opendata-nuernberg/molekula/keyboards/Molekula2/images/v1.0-front-3d.png

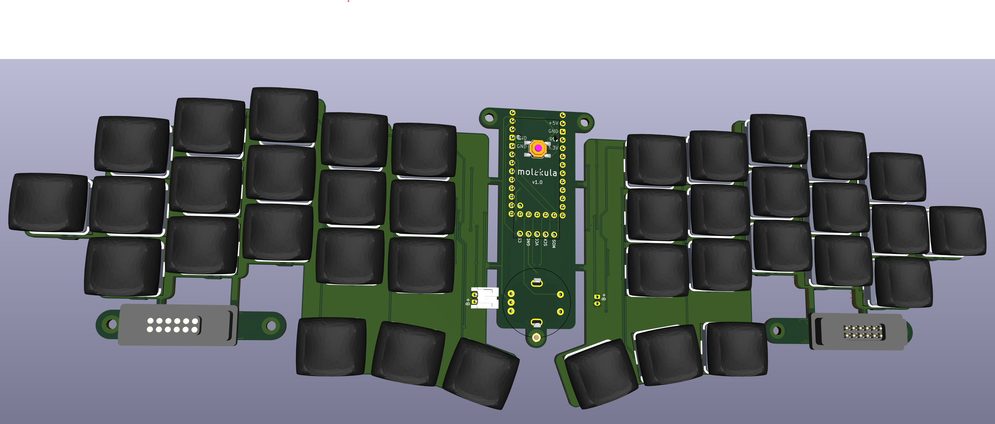
keyboards/Molekula2/images/v1.0-front-3d.png
