opendata-nuernberg/molekula/keyboards/Molekula2/images/v1.0-back-3d.png

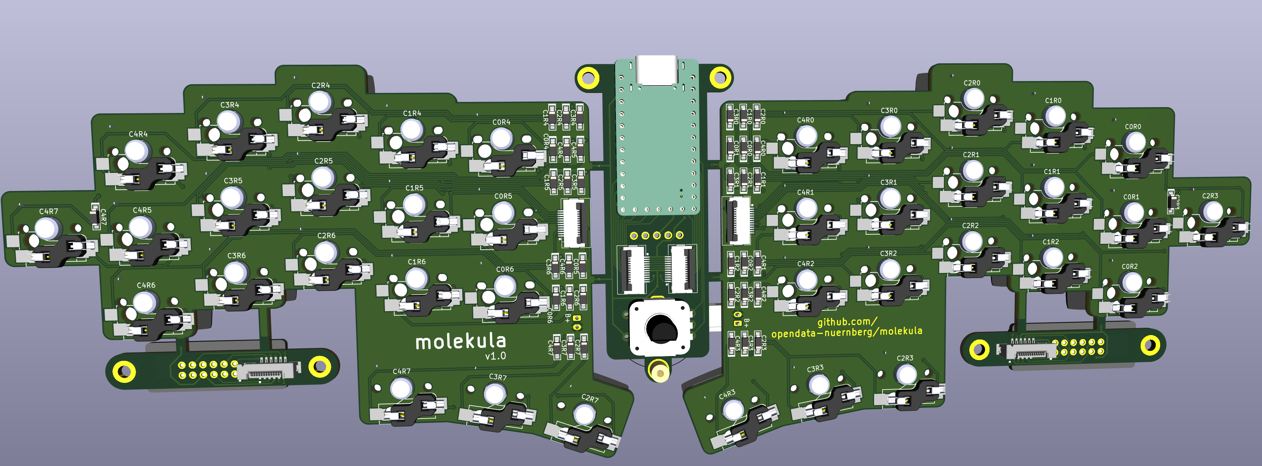
keyboards/Molekula2/images/v1.0-back-3d.png
