opendata-nuernberg/molekula/keyboards/Molekula2/production/202601-order.md

Order Sum: 201,17
[x] 6x MCU - [RP2040 Helios 16M](https://de.aliexpress.com/item/1005010018679591.html)
[x] 350x [Choc hotswap sockets](https://www.aliexpress.us/item/3256808357010978.html)
[x] 100x [MX hotswap sockets](https://www.aliexpress.us/item/3256807045726008.html)
[x] 200x [SMD SOD-123 1N4148w](https://www.aliexpress.us/item/3256809479695335.html) diodes
[x] 10x [Magnetic connector 12pin](https://www.aliexpress.us/item/3256804525488442.html)
[x] 10x rotary encoder, [low profile EC12](https://www.aliexpress.com/item/1005003636548797.html) is recommended (no click though). Versions with click often has issues with power consumption, be careful
[x] 6x [30mm knob](https://www.aliexpress.us/item/3256810097582487.html)
[x] 10x Vertical 12pin 0.5mm [FFC/FPC connector](https://www.aliexpress.com/item/10000000737049.html)
[x] 20x Horizontal 12pin 0.5mm [FFC/FPC connector](https://de.aliexpress.com/item/4001186849063.html)
[x] 20x 12pin 0.5mm 5cm [FFC cable](https://de.aliexpress.com/item/1005007102943270.html) - reverse direction
[x] 20x 12pin 0.5mm 5cm [FFC cable](https://www.aliexpress.com/item/1005007561337665.html) - same side (forward direction)
[x] 10x SMD 4x4x1.5mm [push button](https://de.aliexpress.com/item/1005004312015111.html)
[x] 10 x 2.54mm female pin [headers](https://www.aliexpress.com/item/4001122376295.html)
[x] 5pin [headers](https://de.aliexpress.com/item/1005009098260709.html) - source of pins for socketing, and also a connector for nice!view
