opendata-nuernberg/molekula/keycaps/choc sculpted/choc_caps_print_ready.step

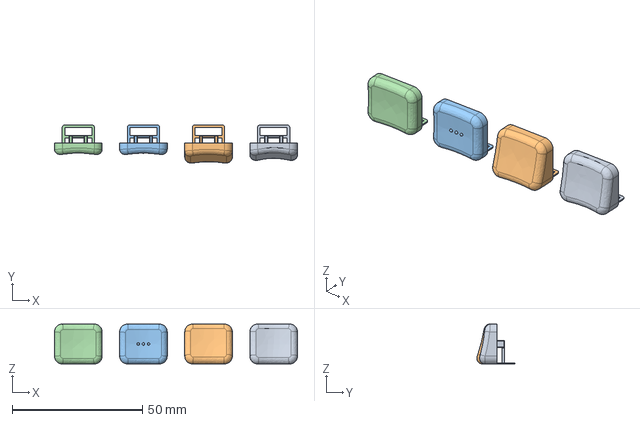
[picture p3: CAD file, 2026-01-31]
keycaps/choc sculpted/choc_caps_print_ready.step
93.3 x 14.7 x 15.3 mm
cap_default_rounded x 4
