opendata-nuernberg/molekula/print_files/keyboard_artisan.3mf

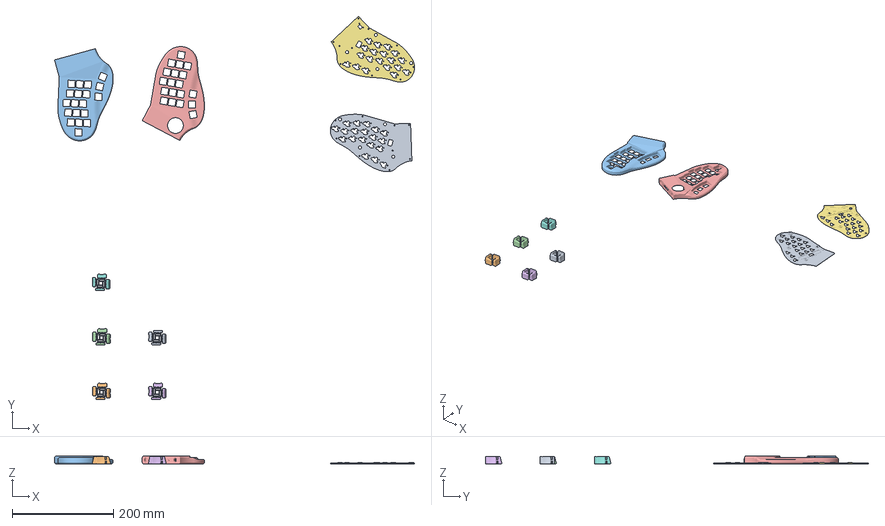
[picture p4: CAD file, 2026-01-31]
print_files/keyboard_artisan.3mf
710.7 x 757.0 x 16.6 mm
bottom-left-choc
Assembly x 5
keyboard
top-right
bottom-right-choc
