opendata-nuernberg/molekula/keycaps/choc sculpted/home_thumb_normal_edge.stl

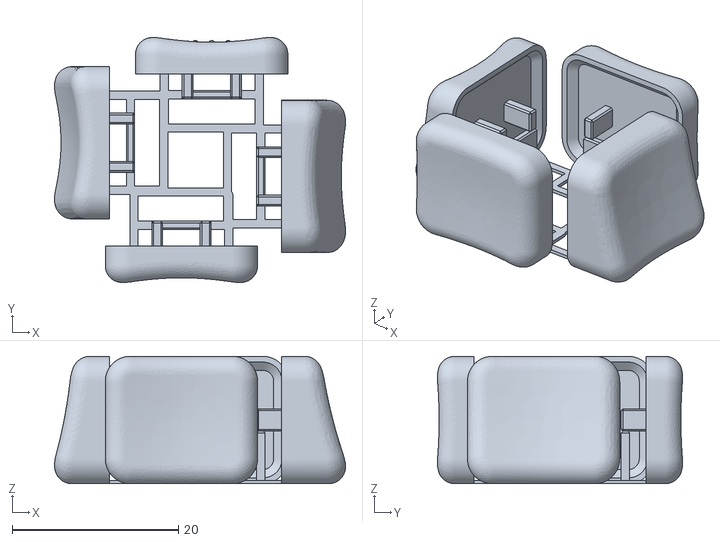
[picture p5: CAD file, 2026-01-31]
keycaps/choc sculpted/home_thumb_normal_edge.stl
35.0 x 29.4 x 15.3
