opendata-nuernberg/molekula/print_files/keyboard_p1s.3mf

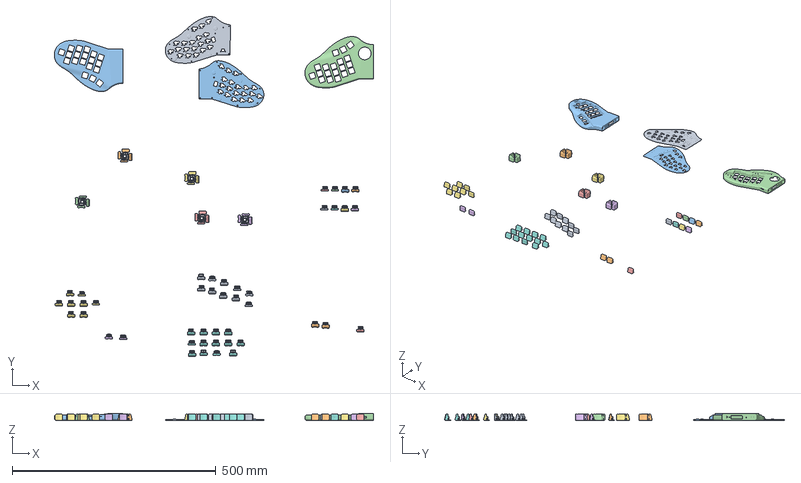
[picture p6: CAD file, 2026-01-31]
print_files/keyboard_p1s.3mf
783.2 x 833.5 x 16.6 mm
bottom-right-choc
Assembly x 7
bottom-left-choc
cap_default_rounded x 9
keyboard_case_v2
top-right
thumb_normal_edge_edge x 2
home_thumb_normal_edge
