opendata-nuernberg/molekula/keyboards/Molekula2/pcb.kicad_pcb

## KiCad design keyboards/Molekula2/pcb.kicad_pcb (2025-12-29)

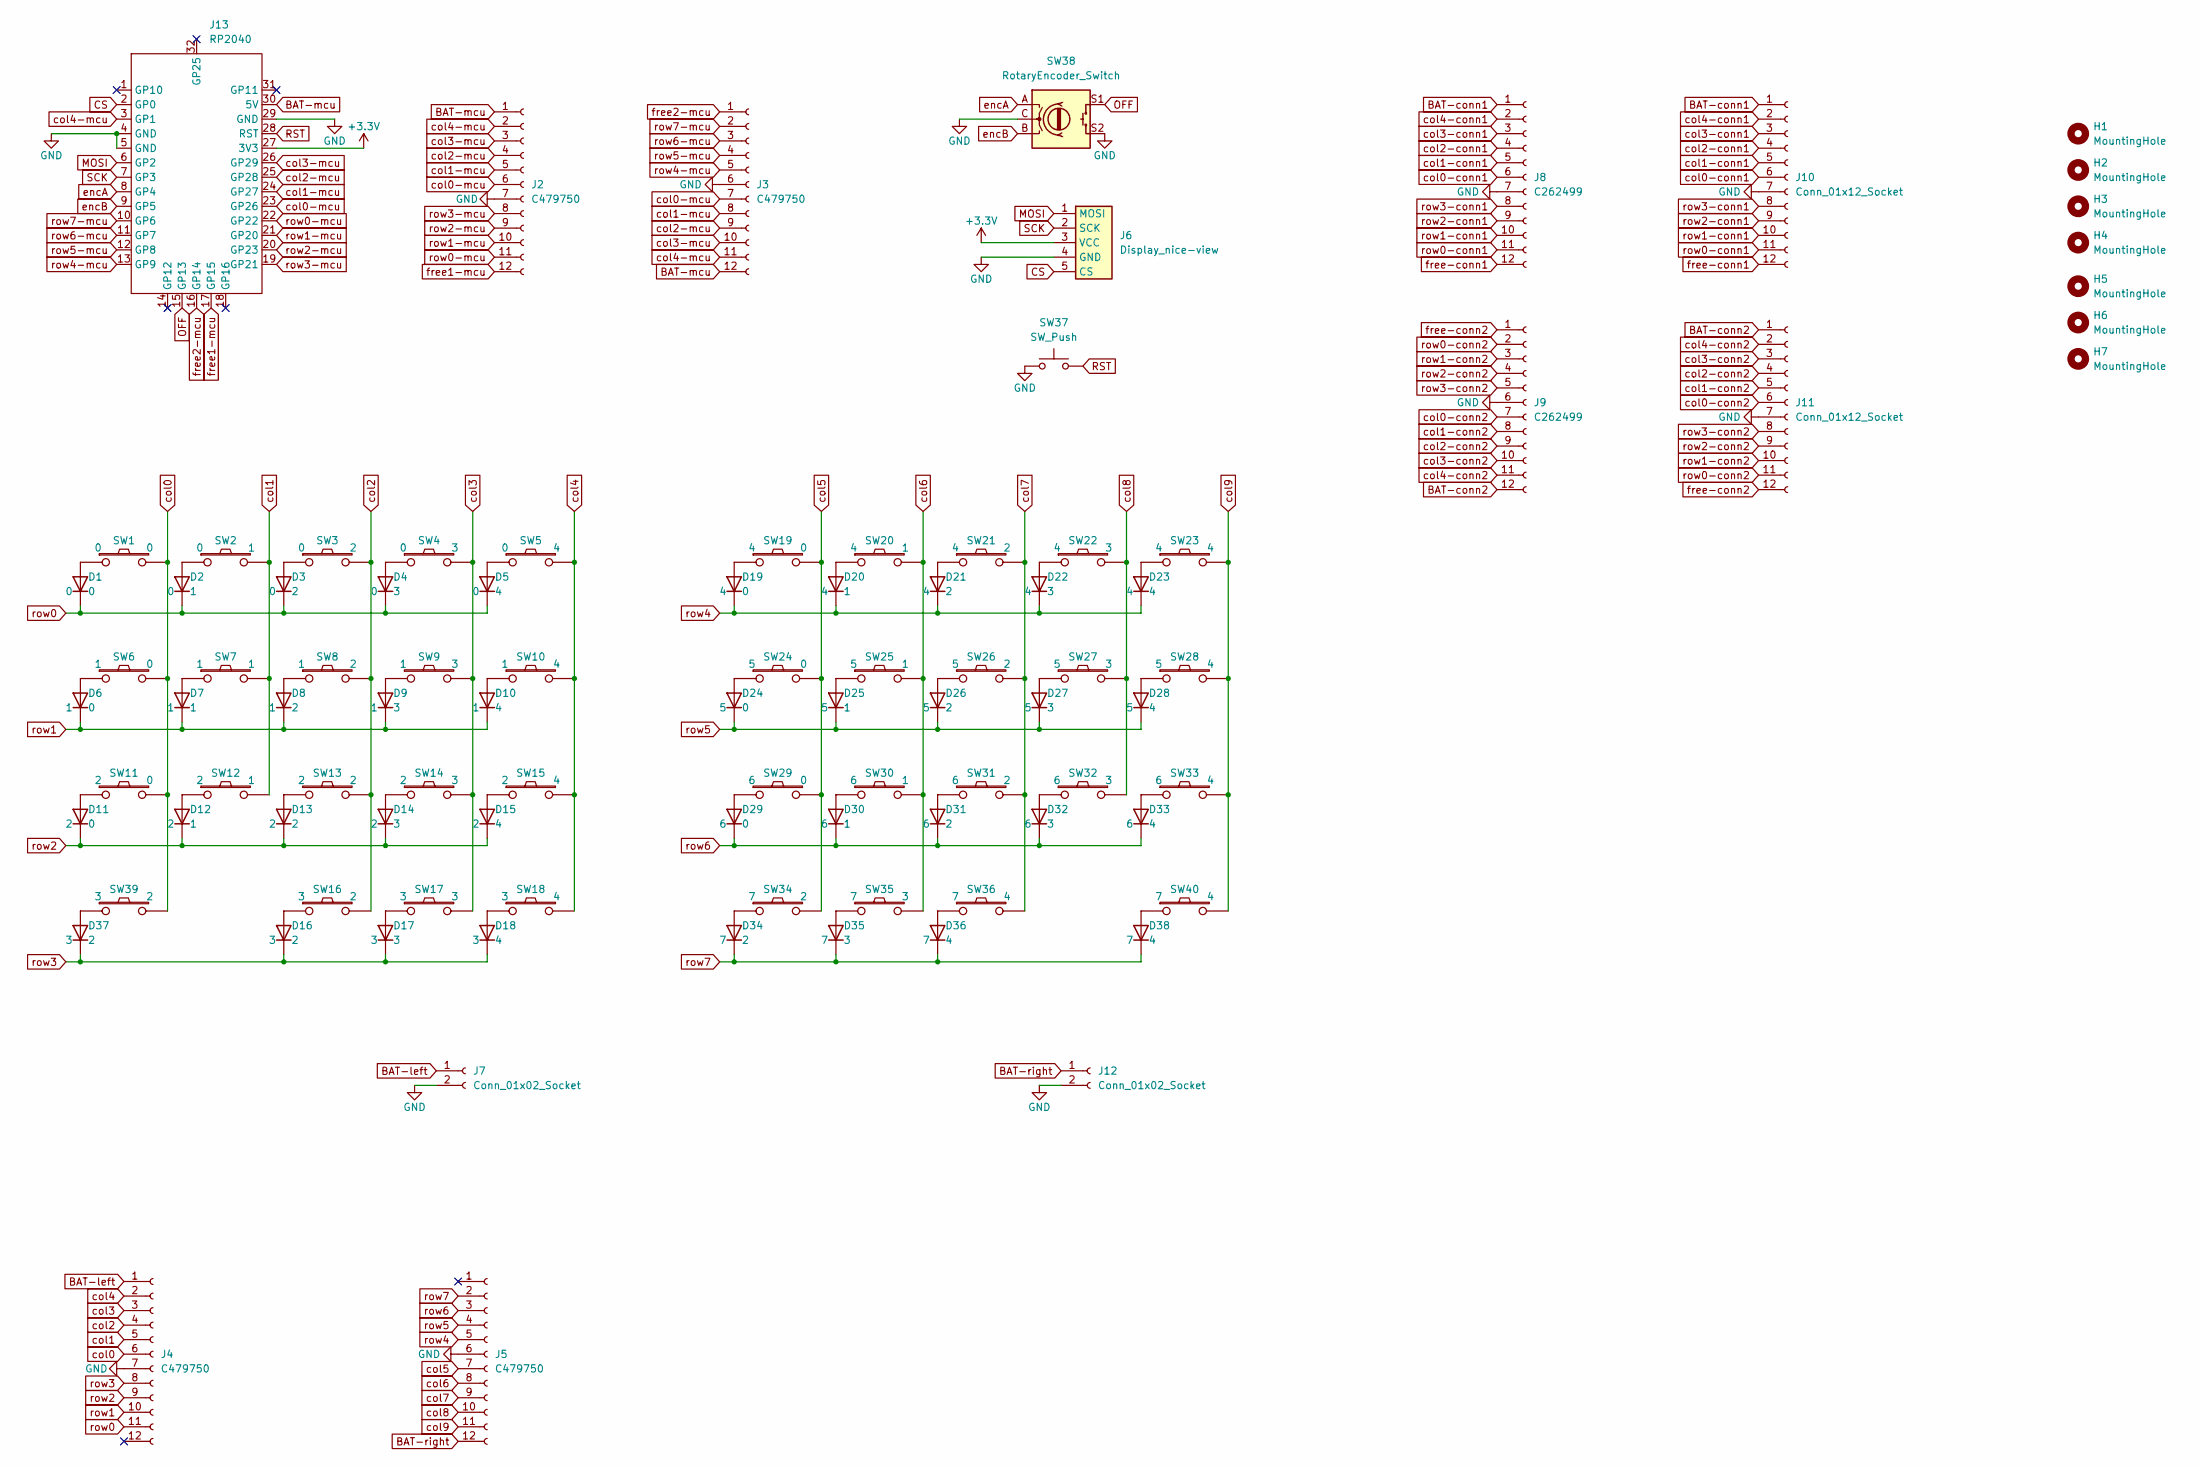
[picture p7: schematic pcb.kicad_sch]

Parts:
D1, D2, D3, D4, D5, D6, D7, D8, D9, D10, D11, D12, D13, D14, D15, D16, D17, D18, D19, D20, D21, D22, D23, D24, D25, D26, D27, D28, D29, D30, D31, D32, D33, D34, D35, D36, D37, D38: C81598; Diode_1N4148-SOD123
H1, H2, H3, H4, H5, H6, H7: MountingHole; Hole_M2-solder-nut-2.5
J2, J3, J4, J5: C479750; Connector_FFC-12pin-0.5mm-horizontal
J6: Display_nice-view
J7, J12: Conn_01x02_Socket; Connector_JST-1x02-2.00mm
J8, J9: C262499; Connector_FFC-12pin-0.5mm-vertical
J10, J11: Conn_01x12_Socket; Connector_Magnetic-12pin
J13: RP2040; MCU_rp2040-helios
SW1, SW2, SW3, SW4, SW5, SW6, SW7, SW8, SW9, SW10, SW11, SW12, SW13, SW14, SW15, SW19, SW20, SW21, SW22, SW23, SW24, SW25, SW26, SW27, SW28, SW29, SW30, SW31, SW32, SW33, SW39, SW40: Switch; Switch_MXKSChoc-miny-hotswap-chocv2-3d
SW16, SW17, SW18, SW34, SW35, SW36: Switch; Switch_KSChoc-miny-hotswap-chocv2-3d
SW37: SW_Push; Button_SW_SPST_SKQG_WithoutStem
SW38: RotaryEncoder_Switch; RotaryEncoder_EC11

Connections:
+3.3V: J6.3 (VCC), J13.27 (3V3)
BAT-conn1: J8.1, J10.1
BAT-conn2: J9.12, J11.1
BAT-left: J4.1, J7.1
BAT-mcu: J2.1, J3.12, J13.30 (5V)
BAT-right: J5.12, J12.1
CS: J6.5 (CS), J13.2 (GP0)
GND: J2.7, J3.6, J4.7, J5.6, J6.4 (GND), J7.2, J8.7, J9.6, J10.7, J11.7, J12.2, J13.4 (GND), J13.5 (GND), J13.29 (GND), SW37.1, SW38.C, SW38.S2
MOSI: J6.1 (MOSI), J13.6 (GP2)
unnamed: D1.2 (A), SW1.1
unnamed: D2.2 (A), SW2.1
unnamed: D3.2 (A), SW3.1
unnamed: D4.2 (A), SW4.1
unnamed: D5.2 (A), SW5.1
unnamed: D6.2 (A), SW6.1
unnamed: D7.2 (A), SW7.1
unnamed: D8.2 (A), SW8.1
unnamed: D9.2 (A), SW9.1
unnamed: D10.2 (A), SW10.1
unnamed: D11.2 (A), SW11.1
unnamed: D12.2 (A), SW12.1
unnamed: D13.2 (A), SW13.1
unnamed: D14.2 (A), SW14.1
unnamed: D15.2 (A), SW15.1
unnamed: D16.2 (A), SW16.1
unnamed: D17.2 (A), SW17.1
unnamed: D18.2 (A), SW18.1
unnamed: D19.2 (A), SW19.1
unnamed: D20.2 (A), SW20.1
unnamed: D21.2 (A), SW21.1
unnamed: D22.2 (A), SW22.1
unnamed: D23.2 (A), SW23.1
unnamed: D24.2 (A), SW24.1
unnamed: D25.2 (A), SW25.1
unnamed: D26.2 (A), SW26.1
unnamed: D27.2 (A), SW27.1
unnamed: D28.2 (A), SW28.1
unnamed: D29.2 (A), SW29.1
unnamed: D30.2 (A), SW30.1
unnamed: D31.2 (A), SW31.1
unnamed: D32.2 (A), SW32.1
unnamed: D33.2 (A), SW33.1
unnamed: D34.2 (A), SW34.1
unnamed: D35.2 (A), SW35.1
unnamed: D36.2 (A), SW36.1
unnamed: D37.2 (A), SW39.1
unnamed: D38.2 (A), SW40.1
OFF: J13.15 (GP13), SW38.S1
RST: J13.28 (RST), SW37.2
SCK: J6.2 (SCK), J13.7 (GP3)
col0: J4.6, SW1.2, SW6.2, SW11.2, SW39.2
col0-conn1: J8.6, J10.6
col0-conn2: J9.7, J11.6
col0-mcu: J2.6, J3.7, J13.23 (GP26)
col1: J4.5, SW2.2, SW7.2, SW12.2
col1-conn1: J8.5, J10.5
col1-conn2: J9.8, J11.5
col1-mcu: J2.5, J3.8, J13.24 (GP27)
col2: J4.4, SW3.2, SW8.2, SW13.2, SW16.2
col2-conn1: J8.4, J10.4
col2-conn2: J9.9, J11.4
col2-mcu: J2.4, J3.9, J13.25 (GP28)
col3: J4.3, SW4.2, SW9.2, SW14.2, SW17.2
col3-conn1: J8.3, J10.3
col3-conn2: J9.10, J11.3
col3-mcu: J2.3, J3.10, J13.26 (GP29)
col4: J4.2, SW5.2, SW10.2, SW15.2, SW18.2
col4-conn1: J8.2, J10.2
col4-conn2: J9.11, J11.2
col4-mcu: J2.2, J3.11, J13.3 (GP1)
col5: J5.7, SW19.2, SW24.2, SW29.2, SW34.2
col6: J5.8, SW20.2, SW25.2, SW30.2, SW35.2
col7: J5.9, SW21.2, SW26.2, SW31.2, SW36.2
col8: J5.10, SW22.2, SW27.2, SW32.2
col9: J5.11, SW23.2, SW28.2, SW33.2, SW40.2
encA: J13.8 (GP4), SW38.A
encB: J13.9 (GP5), SW38.B
free1-mcu: J2.12, J13.17 (GP15)
free2-mcu: J3.1, J13.16 (GP14)
free-conn1: J8.12, J10.12
free-conn2: J9.1, J11.12
row0: D1.1 (K), D2.1 (K), D3.1 (K), D4.1 (K), D5.1 (K), J4.11
row0-conn1: J8.11, J10.11
row0-conn2: J9.2, J11.11
row0-mcu: J2.11, J13.22 (GP22)
row1: D6.1 (K), D7.1 (K), D8.1 (K), D9.1 (K), D10.1 (K), J4.10
row1-conn1: J8.10, J10.10
row1-conn2: J9.3, J11.10
row1-mcu: J2.10, J13.21 (GP20)
row2: D11.1 (K), D12.1 (K), D13.1 (K), D14.1 (K), D15.1 (K), J4.9
row2-conn1: J8.9, J10.9
row2-conn2: J9.4, J11.9
row2-mcu: J2.9, J13.20 (GP23)
row3: D16.1 (K), D17.1 (K), D18.1 (K), D37.1 (K), J4.8
row3-conn1: J8.8, J10.8
row3-conn2: J9.5, J11.8
row3-mcu: J2.8, J13.19 (GP21)
row4: D19.1 (K), D20.1 (K), D21.1 (K), D22.1 (K), D23.1 (K), J5.5
row4-mcu: J3.5, J13.13 (GP9)
row5: D24.1 (K), D25.1 (K), D26.1 (K), D27.1 (K), D28.1 (K), J5.4
row5-mcu: J3.4, J13.12 (GP8)
row6: D29.1 (K), D30.1 (K), D31.1 (K), D32.1 (K), D33.1 (K), J5.3
row6-mcu: J3.3, J13.11 (GP7)
row7: D34.1 (K), D35.1 (K), D36.1 (K), D38.1 (K), J5.2
row7-mcu: J3.2, J13.10 (GP6)

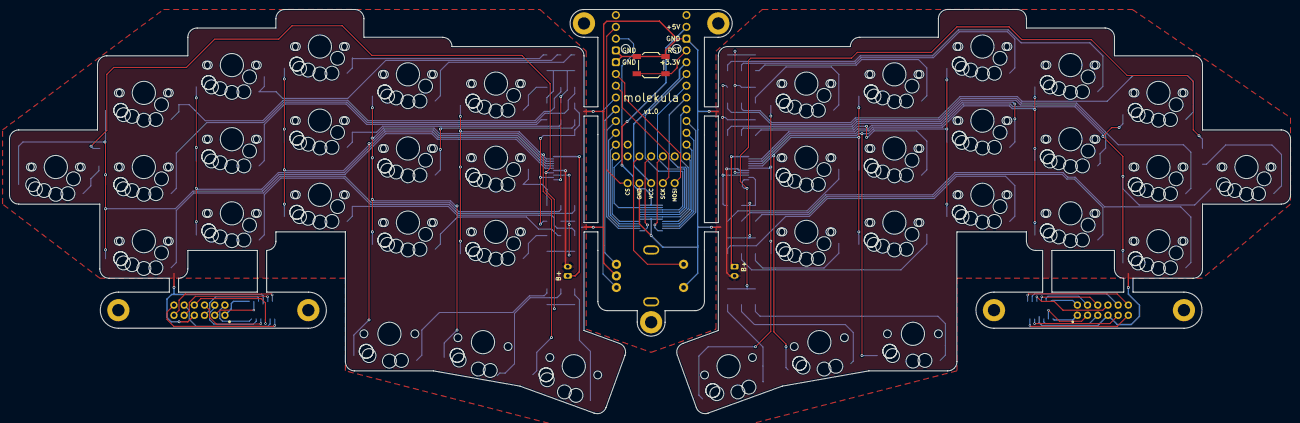
[picture p8: board pcb.kicad_pcb from above]

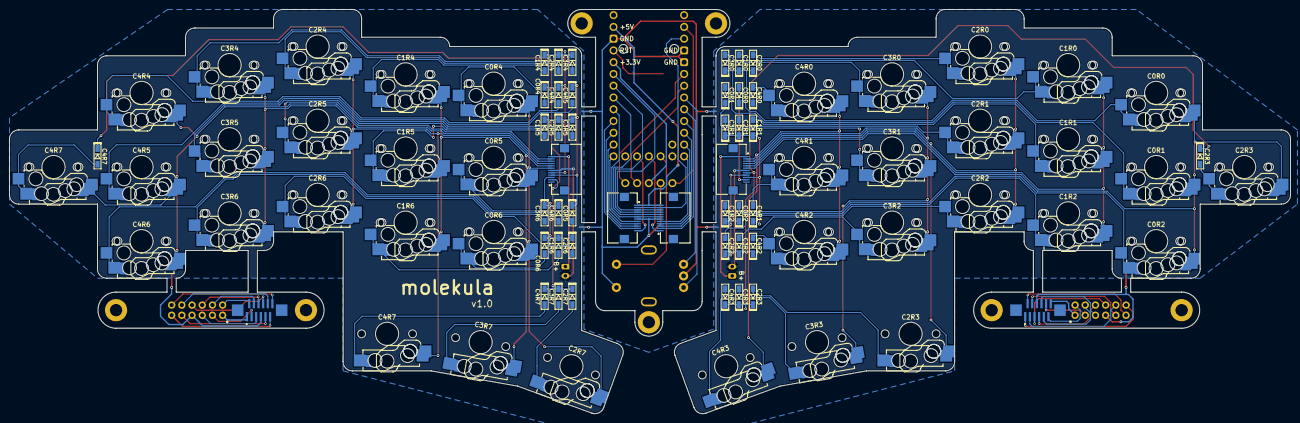
[picture p9: board pcb.kicad_pcb from below]

Board: 2 copper layers, 276.5 x 87.2 mm, 97 parts (54 on the bottom side), 105 nets.
