opendata-nuernberg/molekula/(commit log)

2025-12-29 feat: add 2 more keys to the upper row and updated bom
    [pcb.kicad_pcb, pcb.kicad_sch]
2025-12-29 feat: change MCU to RP2040
    [pcb.kicad_pcb, pcb.kicad_sch]
2025-12-30 (add) updated production files
    [bom.csv, positions.csv]
2025-12-30 (add) bom.zip
2026-01-31 add print files and keycap models
    [choc_caps_print_ready.step, home_thumb_normal_edge.stl, keyboard_artisan.3mf, keyboard_p1s.3mf]
